SysarchLab-CQUPT/2026_JYDCup_Team_OoO/sim/tb_issue_queue.sv

`timescale 1ns/1ps
module tb_issue_queue;
  import rv32_pkg::*;
  import core_types_pkg::*;
  import backend_types_pkg::*;
  logic clk,rst_n;
  logic [1:0] dispatch_valid,dispatch_src1_ready,dispatch_src2_ready,dispatch_accept;
  issue_entry_t dispatch_entry[2],issue_entry;
  logic [2:0] wakeup_valid;
  logic [1:0] select_wakeup_valid;
  logic [7:0] load_mem_ready_bitmap;
  logic [1:0] dispatch_mem_ready;
  preg_t wakeup_preg[3];
  preg_t select_wakeup_preg[2];
  logic issue_valid,issue_ready,flush,recovery_valid;
  rob_ptr_t recovery_start,recovery_end;
  logic [3:0] count;
  logic [2:0] bank0_free,bank1_free;
  logic can_accept_one,can_accept_two;

  issue_queue #(.ENTRIES(4)) dut(
    .clk_i(clk),.rst_ni(rst_n),
    .dispatch_valid_i(dispatch_valid),.dispatch_entry_i(dispatch_entry),
    .dispatch_src1_ready_i(dispatch_src1_ready),.dispatch_src2_ready_i(dispatch_src2_ready),
    .dispatch_mem_ready_i(dispatch_mem_ready),
    .dispatch_accept_o(dispatch_accept),.wakeup_valid_i(wakeup_valid),
    .wakeup_preg_i(wakeup_preg),
    .select_wakeup_valid_i(select_wakeup_valid),
    .select_wakeup_preg_i(select_wakeup_preg),
    .load_mem_ready_bitmap_i(load_mem_ready_bitmap),
    .can_accept_one_o(can_accept_one),.can_accept_two_o(can_accept_two),
    .issue_valid_o(issue_valid),.issue_ready_i(issue_ready),
    .issue_entry_o(issue_entry),
    .issue_ps1_o(),.issue_ps2_o(),.issue_pdst_o(),.issue_fast_wakeup_o(),
    .issue_src1_select_hit_o(),.issue_src2_select_hit_o(),
    .flush_i(flush),
    .recovery_valid_i(recovery_valid),
    .recovery_start_i(recovery_start),.recovery_end_i(recovery_end),.count_o(count),
    .bank0_free_o(bank0_free),.bank1_free_o(bank1_free)
  );
  always #5 clk=~clk;

  initial begin
    clk=0;rst_n=0;dispatch_valid=0;dispatch_src1_ready=0;
    dispatch_src2_ready=0;wakeup_valid=0;select_wakeup_valid=0;
    wakeup_preg[0]=0;wakeup_preg[1]=0;wakeup_preg[2]=0;
    select_wakeup_preg[0]=0;select_wakeup_preg[1]=0;
    issue_ready=1;flush=0;recovery_valid=0;recovery_start='0;recovery_end='0;
    load_mem_ready_bitmap='0; dispatch_mem_ready='1;
    dispatch_entry[0]='0;dispatch_entry[1]='0;
    repeat(3)@(posedge clk);rst_n=1;

    @(negedge clk);
    dispatch_valid=2'b11;
    dispatch_entry[0]='0;dispatch_entry[0].valid=1;dispatch_entry[0].op=UOP_ADD;
    dispatch_entry[0].rob_ptr=6'd0;dispatch_entry[0].uop_id=8'h10;
    dispatch_entry[0].pc=32'h1000_0010;dispatch_entry[0].inst=32'h0101_0133;
    dispatch_entry[0].imm=32'h1234_5678;dispatch_entry[0].predicted_pc=32'h1000_0014;
    dispatch_entry[0].uses_ps1=1;dispatch_entry[0].ps1=6'd40;
    dispatch_entry[1]='0;dispatch_entry[1].valid=1;dispatch_entry[1].op=UOP_SUB;
    dispatch_entry[1].rob_ptr=6'd1;dispatch_entry[1].uop_id=8'h11;
    dispatch_entry[1].pc=32'h2000_0020;dispatch_entry[1].inst=32'h4020_81b3;
    dispatch_entry[1].imm=32'h8765_4321;dispatch_entry[1].predicted_pc=32'h2000_0024;
    dispatch_src1_ready=2'b10;dispatch_src2_ready=2'b11;
    #1;assert(dispatch_accept==2'b11) else $fatal(1,"dual dispatch rejected");
    @(posedge clk);@(negedge clk);dispatch_valid=0;
    #1;assert(issue_valid && issue_entry.uop_id==8'h11 &&
              issue_entry.pc==32'h2000_0020 &&
              issue_entry.inst==32'h4020_81b3 &&
              issue_entry.imm==32'h8765_4321 &&
              issue_entry.predicted_pc==32'h2000_0024)
      else $fatal(1,"younger ready uop did not bypass blocked older uop");
    @(posedge clk);@(negedge clk);
    #1;assert(!issue_valid) else $fatal(1,"blocked uop issued before wakeup");
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
